funvill/montreal-skytrain-pcb/test-results/preview-schematic-square.png

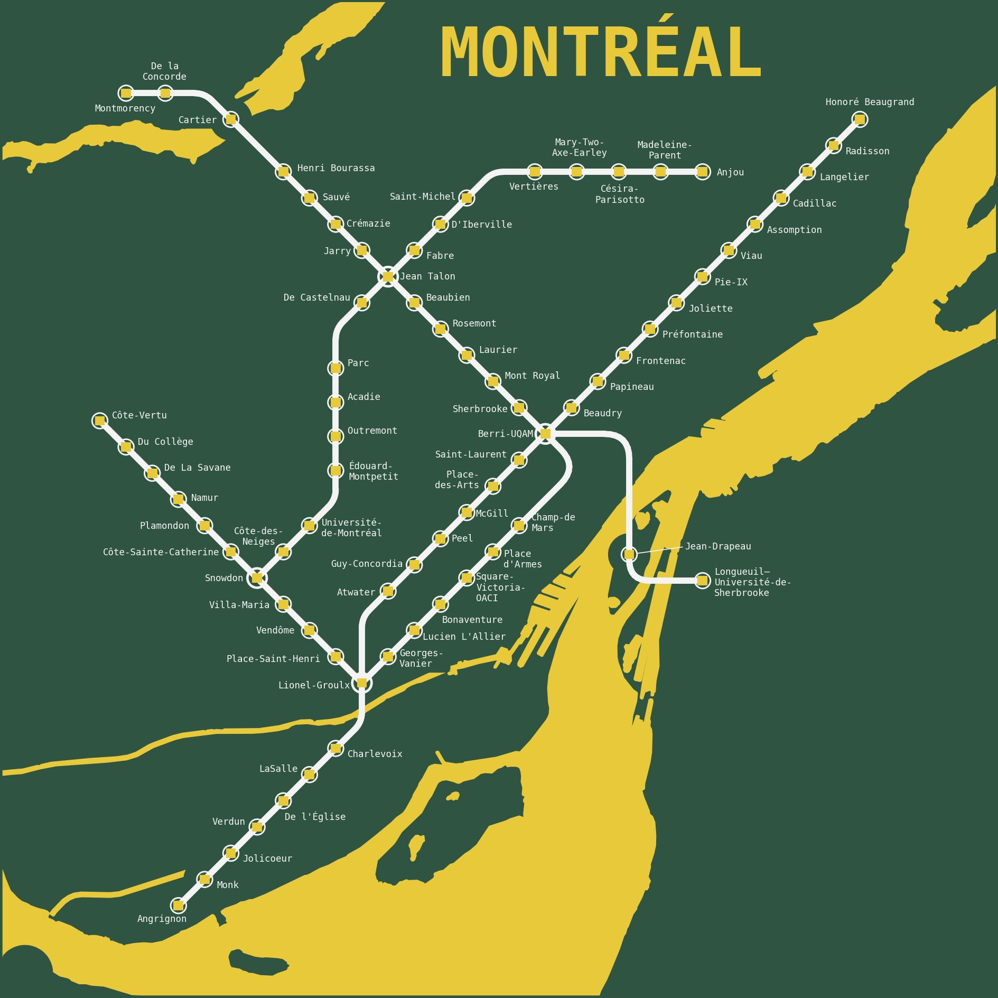
test-results/preview-schematic-square.png
