funvill/montreal-skytrain-pcb/test-results/preview-schematic.png

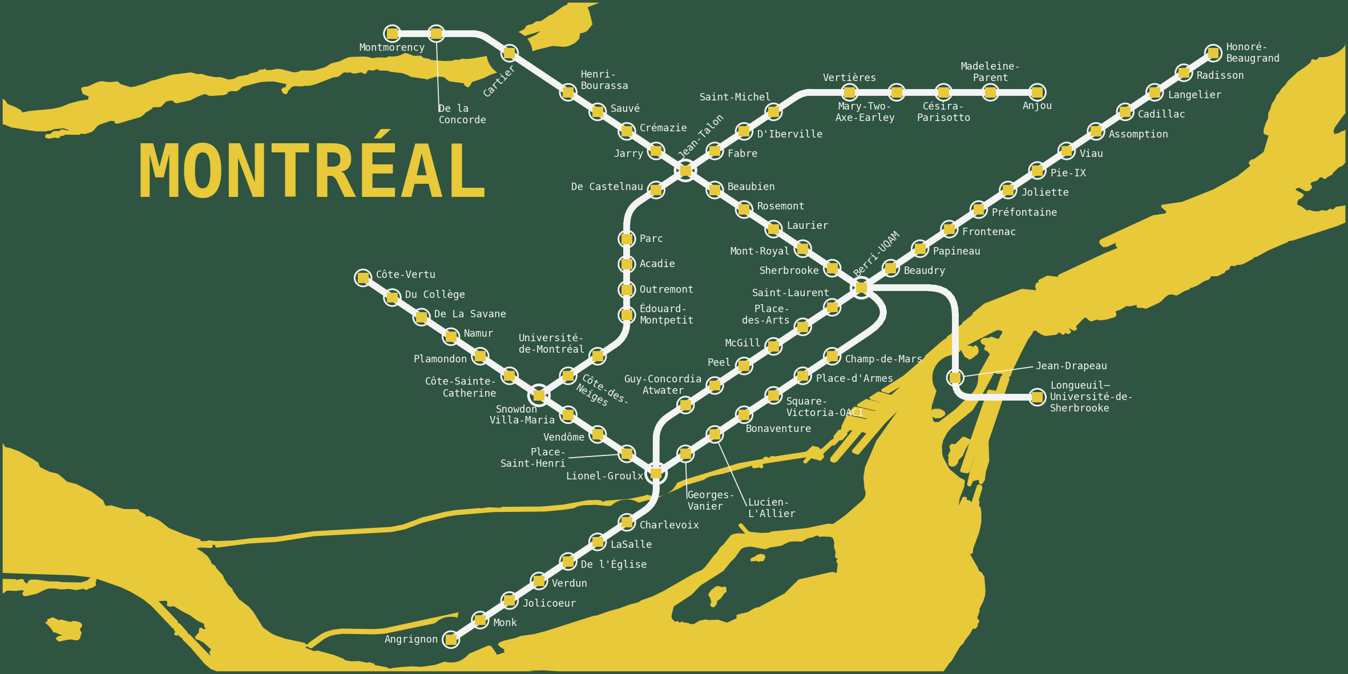
test-results/preview-schematic.png
