funvill/montreal-skytrain-pcb/hardware/jlcpcb/bom-raw.csv

Reference | Value | Footprint | LCSC Part | LCSC | DNP
+5V1,+5V2,GND1,LED_IN1,LED_OUT1,TP1-TP4 | TestPoint | TestPoint:TestPoint_Pad_3.0x3.0mm
C1 | 100uF,6.3V,X5R | Capacitor_SMD:C_1206_3216Metric |  | C15008
LED1-LED73 | XL-1615RGBC-WS2812B | C5349954-led:LED-SMD_4P-L1.6-W1.5_XL-1615RGBC-WS2812B-1 | C5349954
R1 | 330R | Resistor_SMD:R_0402_1005Metric |  | C25104
ROW0-ROW7 | 10uF,10V,X5R | Capacitor_SMD:C_0402_1005Metric |  | C52923
U1 | XIAO-RP2040-DIP | Seeed Studio XIAO:XIAO-RP2040-SMD
