funvill/montreal-skytrain-pcb/hardware/jlcpcb/montreal-skytrain-pcb-2026-10-18-1853-bom-jlcpcb.csv

Comment | Designator | Footprint | LCSC Part #
100uF,6.3V,X5R | C1 | C_1206_3216Metric | C15008
XL-1615RGBC-WS2812B | LED1,LED2,LED3,LED4,LED5,LED6,LED7,LED8,LED9,LED10,LED11,LED12,LED13,LED14,LED15,LED16,LED17,LED18,LED19,LED20,LED21,LED22,LED23,LED24,LED25,LED26,LED27,LED28,LED29,LED30,LED31,LED32,LED33,LED34,LED35,LED36,LED37,LED38,LED39,LED40,LED41,LED42,LED43,LED44,LED45,LED46,LED47,LED48,LED49,LED50,LED51,LED52,LED53,LED54,LED55,LED56,LED57,LED58,LED59,LED60,LED61,LED62,LED63,LED64,LED65,LED66,LED67,LED68,LED69,LED70,LED71,LED72,LED73 | LED-SMD_4P-L1.6-W1.5_XL-1615RGBC-WS2812B-1 | C5349954
330R | R1 | R_0402_1005Metric | C25104
10uF,10V,X5R | ROW0,ROW1,ROW2,ROW3,ROW4,ROW5,ROW6,ROW7 | C_0402_1005Metric | C52923
