funvill/montreal-skytrain-pcb/test-results/geo-preview.png

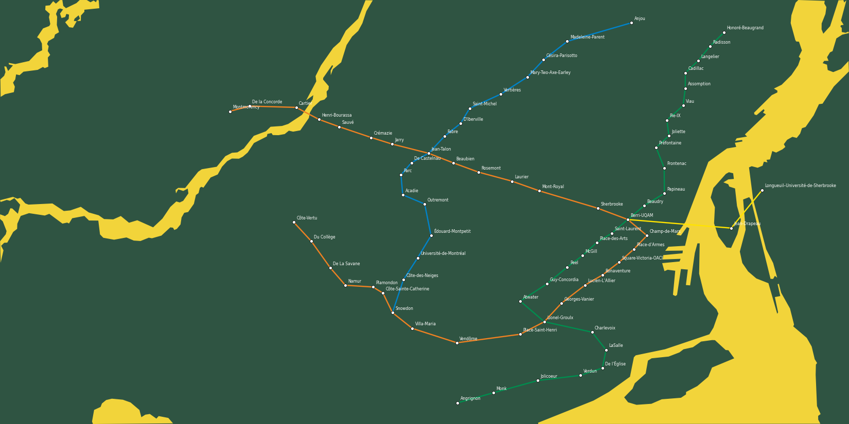
test-results/geo-preview.png
