funvill/montreal-skytrain-pcb/test-results/preview.png

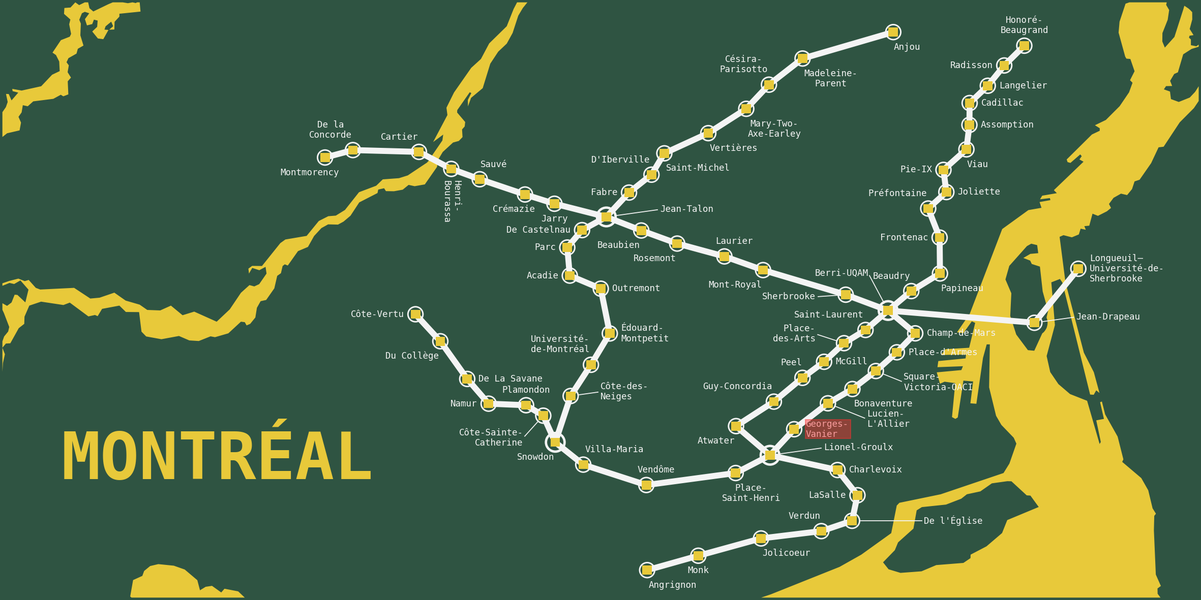
test-results/preview.png
