funvill/montreal-skytrain-pcb/hardware/montreal-metro-pcb.kicad_pcb

## KiCad design hardware/montreal-metro-pcb.kicad_pcb (2026-10-19)

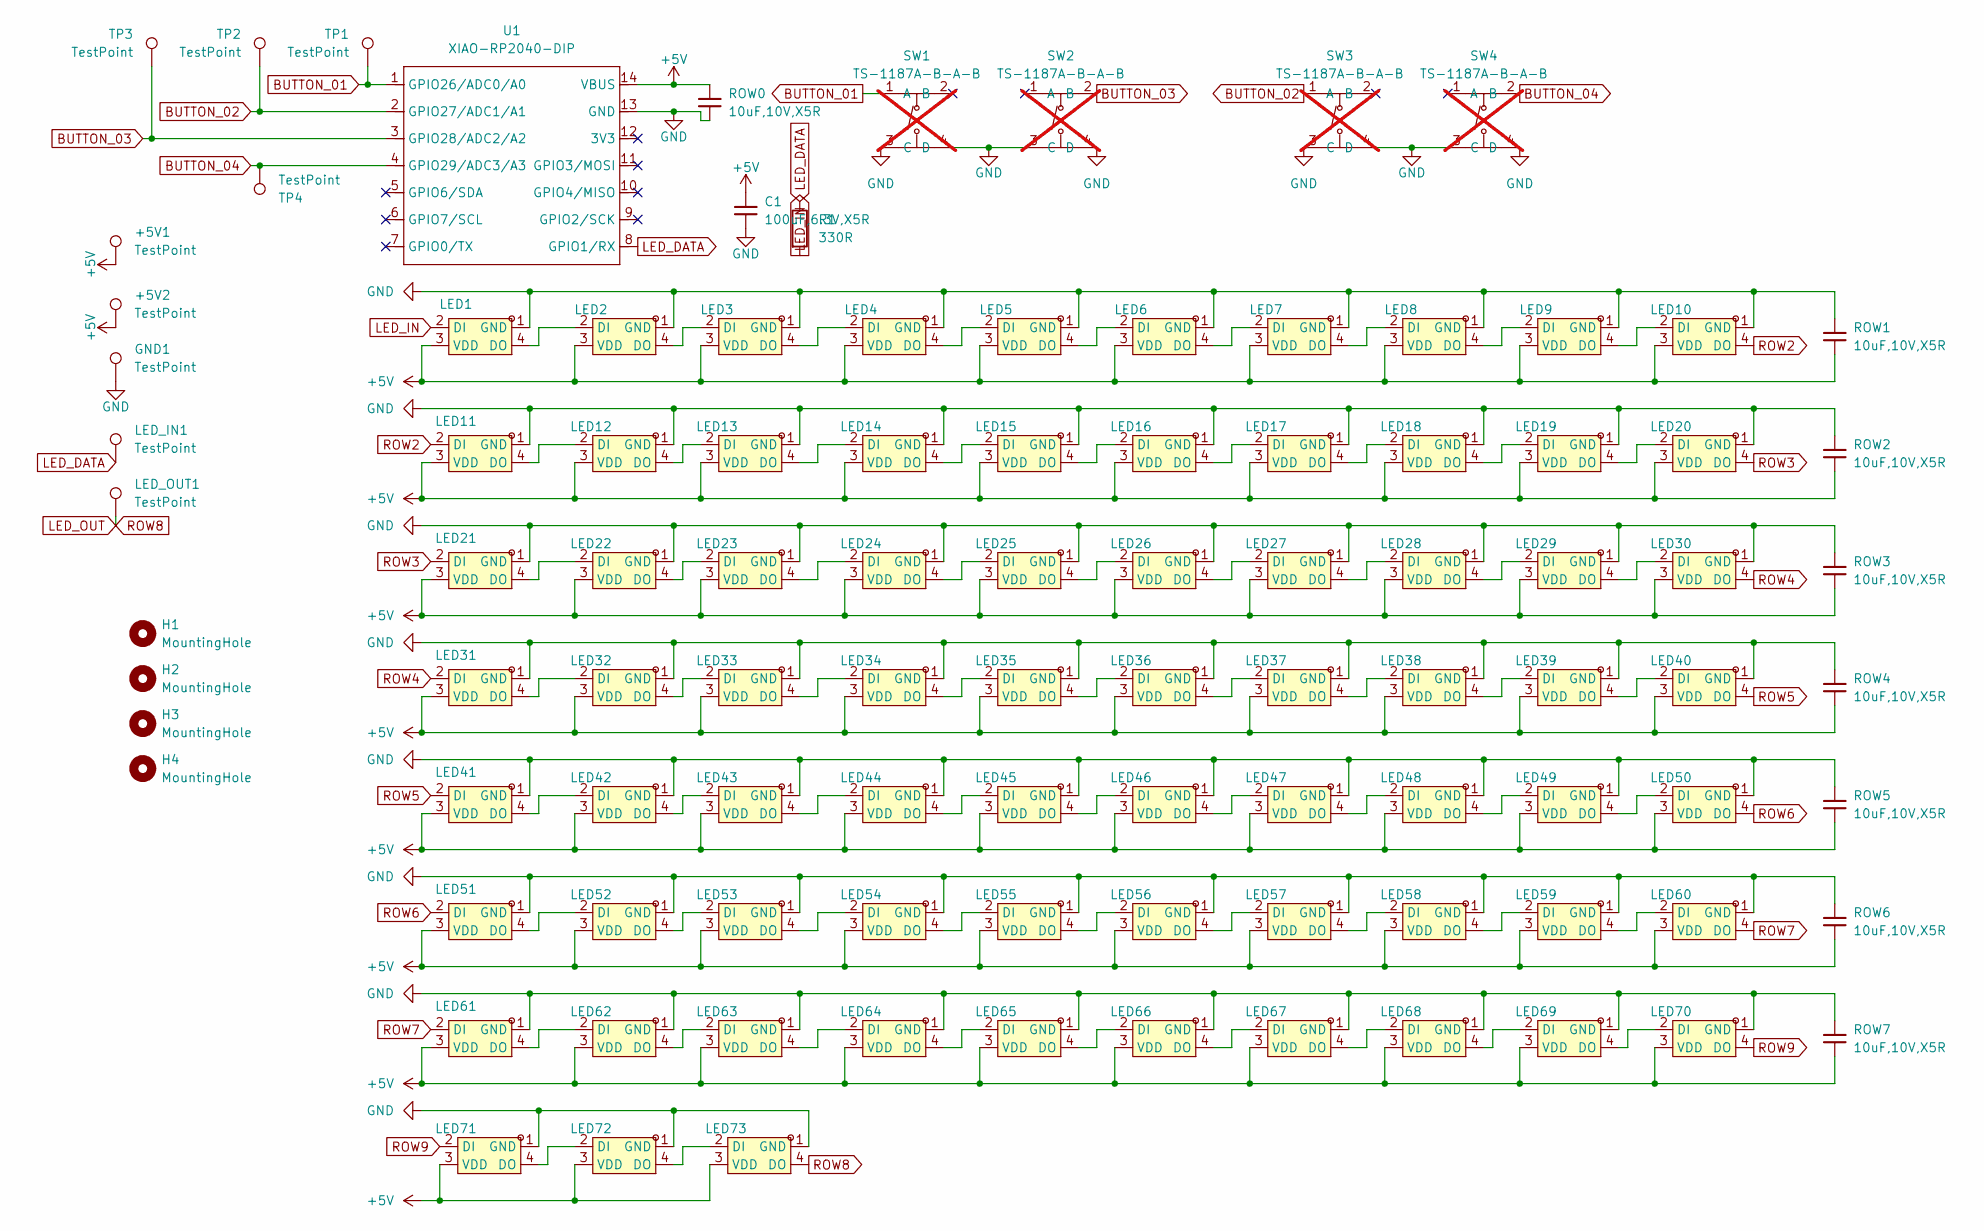
[picture p7: schematic montreal-metro-pcb.kicad_sch]

Parts:
+5V1, +5V2: TestPoint; TestPoint_Pad_3.0x3.0mm
C1: 100uF,6.3V,X5R; C_1206_3216Metric; MFGPN CL31A107MQHNNNE; LCSC C15008
GND1: TestPoint; TestPoint_Pad_3.0x3.0mm
H1, H2, H3, H4: MountingHole; MountingHole_3.2mm_M3_DIN965_Pad_TopBottom
LED1, LED2, LED3, LED4, LED5, LED6, LED7, LED8, LED9, LED10, LED11, LED12, LED13, LED14, LED15, LED16, LED17, LED18, LED19, LED20, LED21, LED22, LED23, LED24, LED25, LED26, LED27, LED28, LED29, LED30, LED31, LED32, LED33, LED34, LED35, LED36, LED37, LED38, LED39, LED40, LED41, LED42, LED43, LED44, LED45, LED46, LED47, LED48, LED49, LED50, LED51, LED52, LED53, LED54, LED55, LED56, LED57, LED58, LED59, LED60, LED61, LED62, LED63, LED64, LED65, LED66, LED67, LED68, LED69, LED70, LED71, LED72, LED73: XL-1615RGBC-WS2812B; LED-SMD_4P-L1.6-W1.5_XL-1615RGBC-WS2812B-1; LCSC Part C5349954
LED_IN1: TestPoint; TestPoint_Pad_3.0x3.0mm
LED_OUT1: TestPoint; TestPoint_Pad_3.0x3.0mm
R1: 330R; R_0402_1005Metric; MFGPN 0402WGF3300TCE; LCSC C25104
ROW0, ROW1, ROW2, ROW3, ROW4, ROW5, ROW6, ROW7: 10uF,10V,X5R; C_0402_1005Metric; MFGPN CL05A105KA5NQNC; LCSC C52923
SW1, SW2, SW3, SW4: TS-1187A-B-A-B; SW-SMD_4P-L5.1-W5.1-P3.70-LS6.5-TL_H1.5; LCSC Part C318884; not fitted
TP1, TP2, TP3, TP4: TestPoint; TestPoint_Pad_3.0x3.0mm
U1: XIAO-RP2040-DIP; XIAO-RP2040-SMD

Connections:
+5V: +5V1.1 (1_1), +5V2.1 (1_1), C1.1, LED1.3 (VDD), LED2.3 (VDD), LED3.3 (VDD), LED4.3 (VDD), LED5.3 (VDD), LED6.3 (VDD), LED7.3 (VDD), LED8.3 (VDD), LED9.3 (VDD), LED10.3 (VDD), LED11.3 (VDD), LED12.3 (VDD), LED13.3 (VDD), LED14.3 (VDD), LED15.3 (VDD), LED16.3 (VDD), LED17.3 (VDD), LED18.3 (VDD), LED19.3 (VDD), LED20.3 (VDD), LED21.3 (VDD), LED22.3 (VDD), LED23.3 (VDD), LED24.3 (VDD), LED25.3 (VDD), LED26.3 (VDD), LED27.3 (VDD), LED28.3 (VDD), LED29.3 (VDD), LED30.3 (VDD), LED31.3 (VDD), LED32.3 (VDD), LED33.3 (VDD), LED34.3 (VDD), LED35.3 (VDD), LED36.3 (VDD), LED37.3 (VDD), LED38.3 (VDD), LED39.3 (VDD), LED40.3 (VDD), LED41.3 (VDD), LED42.3 (VDD), LED43.3 (VDD), LED44.3 (VDD), LED45.3 (VDD), LED46.3 (VDD), LED47.3 (VDD), LED48.3 (VDD), LED49.3 (VDD), LED50.3 (VDD), LED51.3 (VDD), LED52.3 (VDD), LED53.3 (VDD), LED54.3 (VDD), LED55.3 (VDD), LED56.3 (VDD), LED57.3 (VDD), LED58.3 (VDD), LED59.3 (VDD), LED60.3 (VDD), LED61.3 (VDD), LED62.3 (VDD), LED63.3 (VDD), LED64.3 (VDD), LED65.3 (VDD), LED66.3 (VDD), LED67.3 (VDD), LED68.3 (VDD), LED69.3 (VDD), LED70.3 (VDD), LED71.3 (VDD), LED72.3 (VDD), LED73.3 (VDD), ROW0.1, ROW1.2, ROW2.2, ROW3.2, ROW4.2, ROW5.2, ROW6.2, ROW7.2, U1.14 (VBUS)
BUTTON_01: SW1.1 (A), TP1.1 (1_1), U1.1 (GPIO26/ADC0/A0)
BUTTON_02: SW3.1 (A), TP2.1 (1_1), U1.2 (GPIO27/ADC1/A1)
BUTTON_03: SW2.2 (B), TP3.1 (1_1), U1.3 (GPIO28/ADC2/A2)
BUTTON_04: SW4.2 (B), TP4.1 (1_1), U1.4 (GPIO29/ADC3/A3)
GND: C1.2, GND1.1 (1_1), LED1.1 (GND), LED2.1 (GND), LED3.1 (GND), LED4.1 (GND), LED5.1 (GND), LED6.1 (GND), LED7.1 (GND), LED8.1 (GND), LED9.1 (GND), LED10.1 (GND), LED11.1 (GND), LED12.1 (GND), LED13.1 (GND), LED14.1 (GND), LED15.1 (GND), LED16.1 (GND), LED17.1 (GND), LED18.1 (GND), LED19.1 (GND), LED20.1 (GND), LED21.1 (GND), LED22.1 (GND), LED23.1 (GND), LED24.1 (GND), LED25.1 (GND), LED26.1 (GND), LED27.1 (GND), LED28.1 (GND), LED29.1 (GND), LED30.1 (GND), LED31.1 (GND), LED32.1 (GND), LED33.1 (GND), LED34.1 (GND), LED35.1 (GND), LED36.1 (GND), LED37.1 (GND), LED38.1 (GND), LED39.1 (GND), LED40.1 (GND), LED41.1 (GND), LED42.1 (GND), LED43.1 (GND), LED44.1 (GND), LED45.1 (GND), LED46.1 (GND), LED47.1 (GND), LED48.1 (GND), LED49.1 (GND), LED50.1 (GND), LED51.1 (GND), LED52.1 (GND), LED53.1 (GND), LED54.1 (GND), LED55.1 (GND), LED56.1 (GND), LED57.1 (GND), LED58.1 (GND), LED59.1 (GND), LED60.1 (GND), LED61.1 (GND), LED62.1 (GND), LED63.1 (GND), LED64.1 (GND), LED65.1 (GND), LED66.1 (GND), LED67.1 (GND), LED68.1 (GND), LED69.1 (GND), LED70.1 (GND), LED71.1 (GND), LED72.1 (GND), LED73.1 (GND), ROW0.2, ROW1.1, ROW2.1, ROW3.1, ROW4.1, ROW5.1, ROW6.1, ROW7.1, SW1.3 (C), SW1.4 (D), SW2.3 (C), SW2.4 (D), SW3.3 (C), SW3.4 (D), SW4.3 (C), SW4.4 (D), U1.13 (GND)
LED_DATA: LED_IN1.1 (1_1), R1.1, U1.8 (GPIO1/RX)
LED_IN: LED1.2 (DI), R1.2
LED_OUT: LED73.4 (DO), LED_OUT1.1 (1_1)
unnamed: LED1.4 (DO), LED2.2 (DI)
unnamed: LED2.4 (DO), LED3.2 (DI)
unnamed: LED3.4 (DO), LED4.2 (DI)
unnamed: LED4.4 (DO), LED5.2 (DI)
unnamed: LED5.4 (DO), LED6.2 (DI)
unnamed: LED6.4 (DO), LED7.2 (DI)
unnamed: LED7.4 (DO), LED8.2 (DI)
unnamed: LED8.4 (DO), LED9.2 (DI)
unnamed: LED9.4 (DO), LED10.2 (DI)
unnamed: LED11.4 (DO), LED12.2 (DI)
unnamed: LED12.4 (DO), LED13.2 (DI)
unnamed: LED13.4 (DO), LED14.2 (DI)
unnamed: LED14.4 (DO), LED15.2 (DI)
unnamed: LED15.4 (DO), LED16.2 (DI)
unnamed: LED16.4 (DO), LED17.2 (DI)
unnamed: LED17.4 (DO), LED18.2 (DI)
unnamed: LED18.4 (DO), LED19.2 (DI)
unnamed: LED19.4 (DO), LED20.2 (DI)
unnamed: LED21.4 (DO), LED22.2 (DI)
unnamed: LED22.4 (DO), LED23.2 (DI)
unnamed: LED23.4 (DO), LED24.2 (DI)
unnamed: LED24.4 (DO), LED25.2 (DI)
unnamed: LED25.4 (DO), LED26.2 (DI)
unnamed: LED26.4 (DO), LED27.2 (DI)
unnamed: LED27.4 (DO), LED28.2 (DI)
unnamed: LED28.4 (DO), LED29.2 (DI)
unnamed: LED29.4 (DO), LED30.2 (DI)
unnamed: LED31.4 (DO), LED32.2 (DI)
unnamed: LED32.4 (DO), LED33.2 (DI)
unnamed: LED33.4 (DO), LED34.2 (DI)
unnamed: LED34.4 (DO), LED35.2 (DI)
unnamed: LED35.4 (DO), LED36.2 (DI)
unnamed: LED36.4 (DO), LED37.2 (DI)
unnamed: LED37.4 (DO), LED38.2 (DI)
unnamed: LED38.4 (DO), LED39.2 (DI)
unnamed: LED39.4 (DO), LED40.2 (DI)
unnamed: LED41.4 (DO), LED42.2 (DI)
unnamed: LED42.4 (DO), LED43.2 (DI)
unnamed: LED43.4 (DO), LED44.2 (DI)
unnamed: LED44.4 (DO), LED45.2 (DI)
unnamed: LED45.4 (DO), LED46.2 (DI)
unnamed: LED46.4 (DO), LED47.2 (DI)
unnamed: LED47.4 (DO), LED48.2 (DI)
unnamed: LED48.4 (DO), LED49.2 (DI)
unnamed: LED49.4 (DO), LED50.2 (DI)
unnamed: LED51.4 (DO), LED52.2 (DI)
unnamed: LED52.4 (DO), LED53.2 (DI)
unnamed: LED53.4 (DO), LED54.2 (DI)
unnamed: LED54.4 (DO), LED55.2 (DI)
unnamed: LED55.4 (DO), LED56.2 (DI)
unnamed: LED56.4 (DO), LED57.2 (DI)
unnamed: LED57.4 (DO), LED58.2 (DI)
unnamed: LED58.4 (DO), LED59.2 (DI)
unnamed: LED59.4 (DO), LED60.2 (DI)
unnamed: LED61.4 (DO), LED62.2 (DI)
unnamed: LED62.4 (DO), LED63.2 (DI)
unnamed: LED63.4 (DO), LED64.2 (DI)
unnamed: LED64.4 (DO), LED65.2 (DI)
unnamed: LED65.4 (DO), LED66.2 (DI)
unnamed: LED66.4 (DO), LED67.2 (DI)
unnamed: LED67.4 (DO), LED68.2 (DI)
unnamed: LED68.4 (DO), LED69.2 (DI)
unnamed: LED69.4 (DO), LED70.2 (DI)
unnamed: LED71.4 (DO), LED72.2 (DI)
unnamed: LED72.4 (DO), LED73.2 (DI)
ROW2: LED10.4 (DO), LED11.2 (DI)
ROW3: LED20.4 (DO), LED21.2 (DI)
ROW4: LED30.4 (DO), LED31.2 (DI)
ROW5: LED40.4 (DO), LED41.2 (DI)
ROW6: LED50.4 (DO), LED51.2 (DI)
ROW7: LED60.4 (DO), LED61.2 (DI)
ROW9: LED70.4 (DO), LED71.2 (DI)

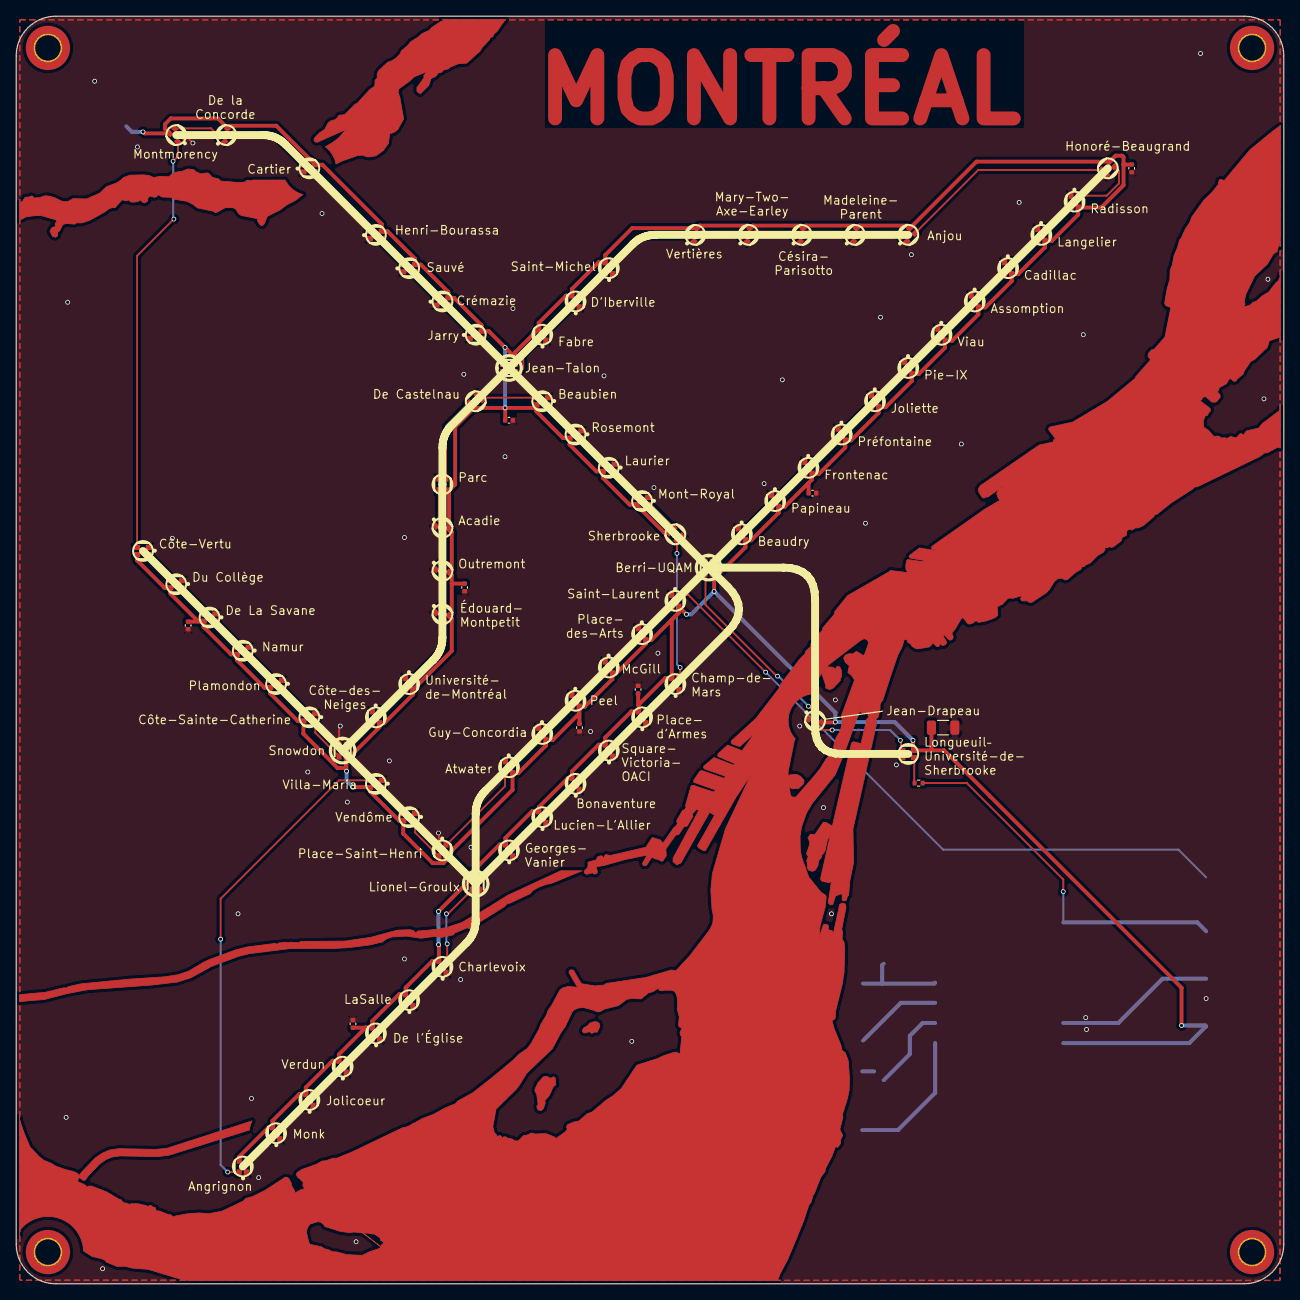
[picture p8: board montreal-metro-pcb.kicad_pcb from above]

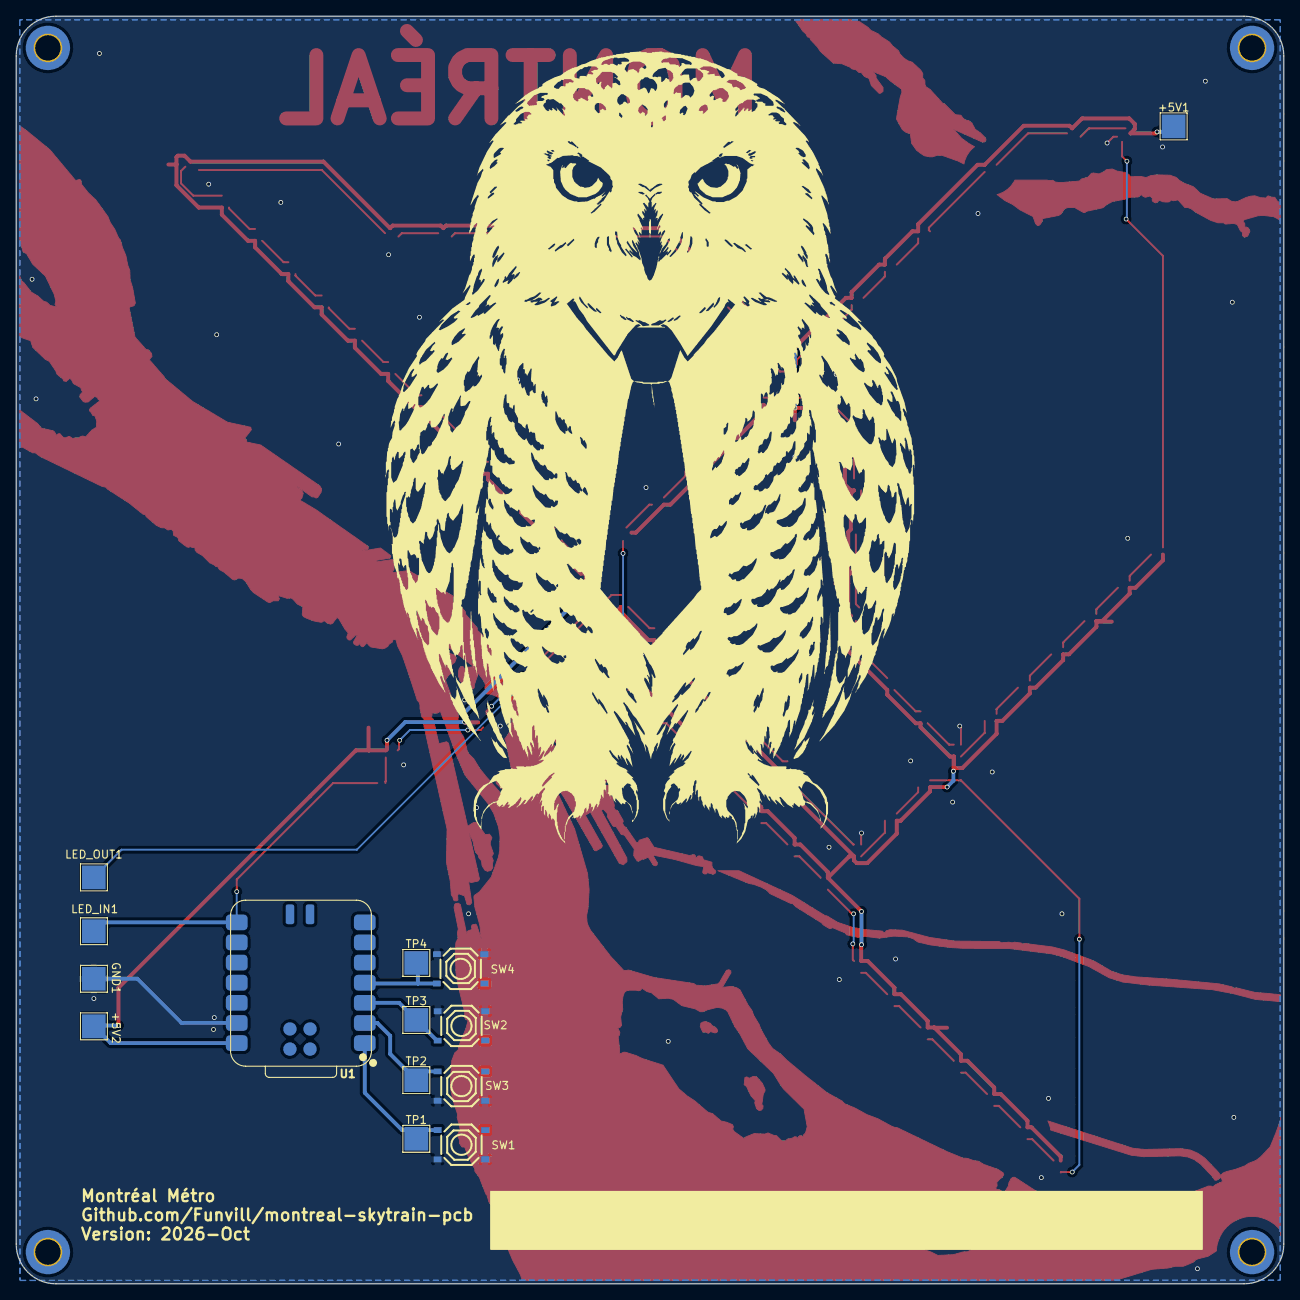
[picture p9: board montreal-metro-pcb.kicad_pcb from below]

Board: 2 copper layers, 160.0 x 160.0 mm, 102 parts (15 on the bottom side), 81 nets.

Other parts of the board:
LOGO1: artwork
