funvill/montreal-skytrain-pcb/(commit log)

2026-10-13 Montréal metro map data: natural and schematic layouts, 73 LEDs
    Port the Vancouver ai-v3 pipeline (tools/, firmware/) and build the
    Montréal data files from OpenStreetMap: 68 metro stations plus the five
    Blue line extension stations.
    Three layouts, all from the same station list and LED chain:
    - input/montreal.json: geographic map, 200 x 100 mm, with a downtown
    magnification so stations clear the 3.3 mm LED pitch floor
    - input/montreal-schematic-square.json: official-map style, 160 x 160 mm,
    45-degree lines with rounded bends over true-proportion land and water
    - input/montreal-schematic.json: the same schematic stretched to 200 x 100 mm
    Tool changes from the Vancouver originals:
    - c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
2026-10-13 Hardware port: 73-LED KiCad project for the square schematic
    Copy the Vancouver v3 KiCad project as montreal-metro-pcb and port it:
    - schematic: add LED69-73 (tools/add_schematic_leds.py); chain and power
    verified from KiCad's netlist (tools/check_led_chain.py)
    - board: add the five footprints, sync pad nets from the netlist, place
    and aim all 73 LEDs, place capacitors and mounting holes clear of the
    artwork (tools/place_parts.py, tools/port_board.py), 160 x 160 mm outline
    - artwork written by export_art.py; idempotent on a second run
    - firmware: regenerated tables, four STM routes and colours
    - library tables now project-relative
    DRC: no clearance, edge, short or courtyard violations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
    [leds.csv, montreal-metro-pcb.kicad_pcb, montreal-metro-pcb.kicad_sch, parts.csv]
2026-10-13 Autoroute the board with Freerouting; DRC clean
    tools/autoroute.py exports a Specctra file from a throwaway copy of the
    board with track-and-via keepouts over the bare-copper front artwork
    (islands kept open), and with the ground plane declared on the back only so
    every front ground pad gets a via. It imports the routed session back.
    tools/stitch_ground.py ties U1's ground pad into the back pour.
    To make the board routable:
    - stations that touch water get a 3.4 mm clearing so vias fit beside them
    - the XIAO and buttons move to (124, 122) mm on the back, away from the
    downtown LEDs; the three test points move to a row below them
    - +5V gets a 0.5 mm net class
    Result: 944 track segments, 82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
    [montreal-metro-pcb.kicad_pcb]
2026-10-13 Apply map markups: label position rule, hand placements, tidier water
    Labels (tools/auto_label.py):
    - rank positions by the cartographers' rule of thumb: upper right, lower
    right, upper left, lower left, middle right, middle left
    - --fixed FILE: hand placements that are applied first and never moved
    - --parallel: give a group of stations leaders at the same angle
    - input/label_overrides-square.json: Cartier lower left, Verdun upper left
    Water (input/build_schematic.py):
    - drop pieces cut off by the board edge under 20 mm^2
    - fill islands under 8 mm^2 or thinner than 0.8 mm
    - drop canal stubs left beside stations by the pad clearings
    - cut the water back under hand-placed labels
    tools/reb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
    [montreal-metro-pcb.kicad_pcb, parts.csv]
2026-10-13 Import the hand label pass from KiCad and freeze it
    41 of 73 station labels were moved, re-wrapped or retyped by hand in KiCad.
    import_labels.py brought them into montreal-schematic-square.json; they are
    now frozen in input/label_overrides-square.json ({station: {label, wrap}}).
    - build_schematic.py re-applies the overrides on every build and cuts the
    water back under each hand-placed label
    - auto_label.py --fixed accepts the new format and never moves them
    - tools/save_label_overrides.py freezes the labels of a data file
    - check_fit: pad and line clearances calibrated to the hand pass
    - hardware/backups/: the board as hand-edited, before any regeneration
    The board file is committed as e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
    [montreal-metro-pcb-2026-10-13-user-label-edits.kicad_pcb, montreal-metro-pcb.kicad_pcb]
2026-10-13 Official names, hand-pass label defaults, and an unrouted board
    - labels: restore the official hyphenated names in the six hand-typed
    labels, keeping the hand-chosen line breaks
    - auto_label: defaults now follow the hand pass - beside the station and
    level with it, right before left, nudged only as far as needed, one side
    per run, above / below alternating on level runs, leaders last
    - board: every track and via removed; routing will be done by hand.
    Artwork regenerated from the frozen labels (water cut back under them)
    - rebuild_board.sh no longer routes unless given --autoroute;
    autoroute.py gains "clear"
    DRC: no violations, 0 schematic parity issues, 167 unconnected items
    (noth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
    [montreal-metro-pcb.kicad_pcb, parts.csv]
2026-10-13 2:1 schematic: relabel with the hand-pass optimiser defaults
    0 collisions; 5 leaders (was 12), 4 rotated labels.
2026-10-18 Hand-routed board, R1 and C1, owl back art, JLCPCB outputs
    The board is now routed by hand with every assembled part on the
    top side. Added:
    - C1, 100 uF 6.3 V 1206 X5R bulk capacitor (LCSC C15008, basic)
    on the +5V trunk.
    - R1, 330 R 0402 (LCSC C25104, basic) in series on the LED data
    line. U1 pin 8 and the LED_IN1 test point are now on LED_DATA;
    LED_IN runs from R1 to LED1 only.
    - The snowy-owl artwork on the back silkscreen as the board-only
    footprint LOGO1, generated by the new tools/svg_to_silk.py.
    - JLCPCB gerbers, BOM and CPL in hardware/jlcpcb, stamped
    2026-10-18-1117; make_jlcpcb.py takes the stamp as an argument.
    - The latest hand label edits, imported and frozen.
    DRC: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
    [bom-raw.csv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]
2026-10-19 Print the silkscreen that crosses the water
    The water is a solder-mask opening, and silkscreen cannot print on an
    opening: JLCPCB clips it, and so does the gerber export with
    --subtract-soldermask. The yellow line to Jean-Drapeau and Longueuil,
    the Jean-Drapeau ring and its leader, and a leader on the Lachine
    Canal were all missing from the silk: 12.7 mm² of ink in 6 places.
    The new tools/mask_under_silk.py cuts the front silk, grown by
    0.2 mm, out of the F.Mask water polygons, so the copper stays but
    mask covers it under the ink. It records what it replaced in
    montreal-metro-pcb.kicad_pcb.silk-mask.json, so it can be re-run,
    and rebuild_board.sh runs it after export_art.py.
    JLCPCB output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
    [montreal-metro-pcb-B_Cu.gbl, montreal-metro-pcb-B_Mask.gbs, montreal-metro-pcb-B_Paste.gbp, montreal-metro-pcb-B_Silkscreen.gbo, montreal-metro-pcb-Edge_Cuts.gm1, montreal-metro-pcb-F_Cu.gtl, montreal-metro-pcb-F_Mask.gts, montreal-metro-pcb-F_Paste.gtp]
2026-10-19 Record the version sent to JLCPCB on 2026-10-18
    Adds manufactured/jlcpcb_2026Oct18-191040.zip, the package uploaded to
    JLCPCB; its contents are identical to the 2026-10-18-1853 outputs in
    hardware/jlcpcb. The top-level README now describes the board, notes
    the manufacture date and shows fresh front and back renders.
2026-10-19 Lessons learned from the Montréal board
    lessons-learned.md now leads with what this board taught (Part A),
    then a pre-order checklist built from both boards (Part C), and keeps
    the Vancouver v3 lessons unchanged (Part B). Part A ends with the
    known issues in the boards as ordered, to check when they arrive.
    README and the runbook link to it.
